IDD-su18/hw3-jasonxzhou/misc/image002.jpg

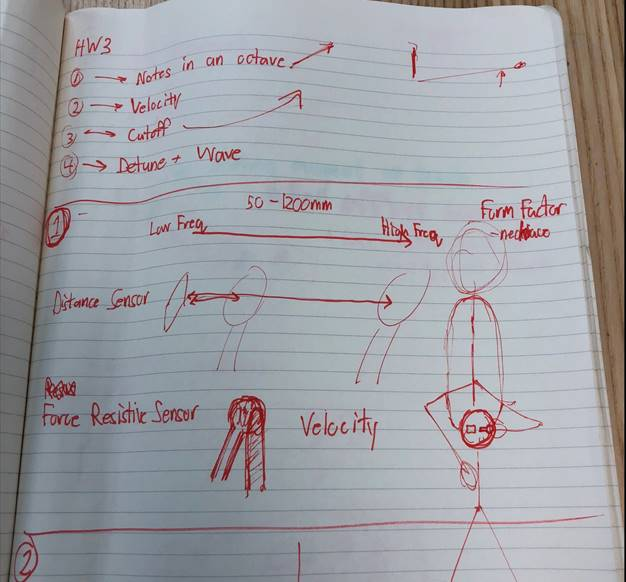
misc/image002.jpg
