IDD-su18/hw3-jasonxzhou/misc/image005.jpg

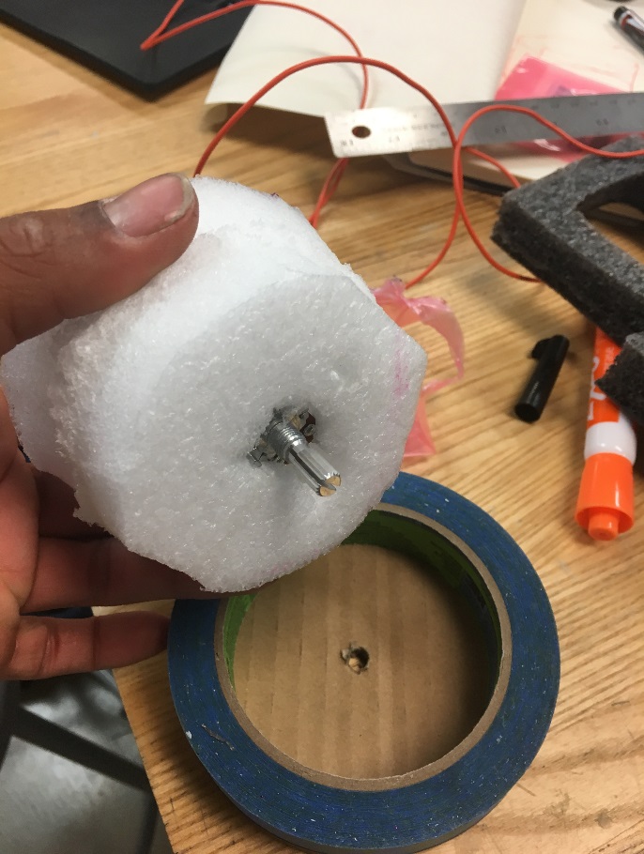
misc/image005.jpg
