IDD-su18/hw3-jasonxzhou/misc/image007.jpg

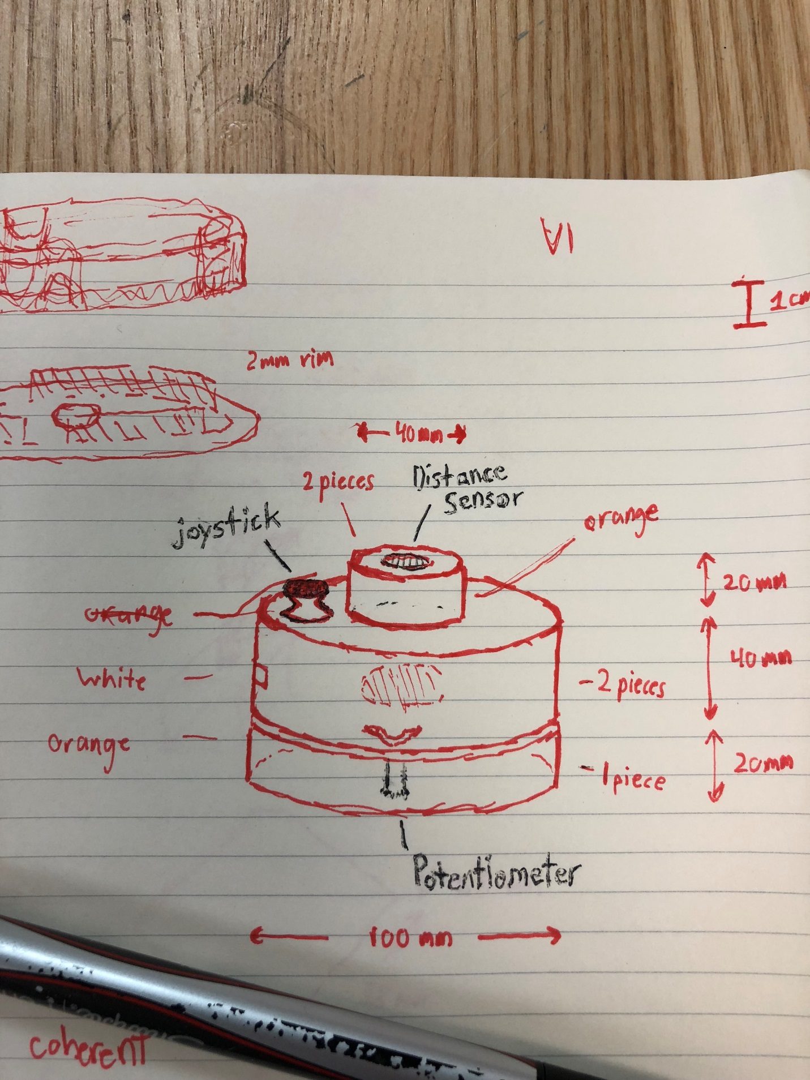
misc/image007.jpg
