IDD-su18/hw3-jasonxzhou/misc/image025.jpg

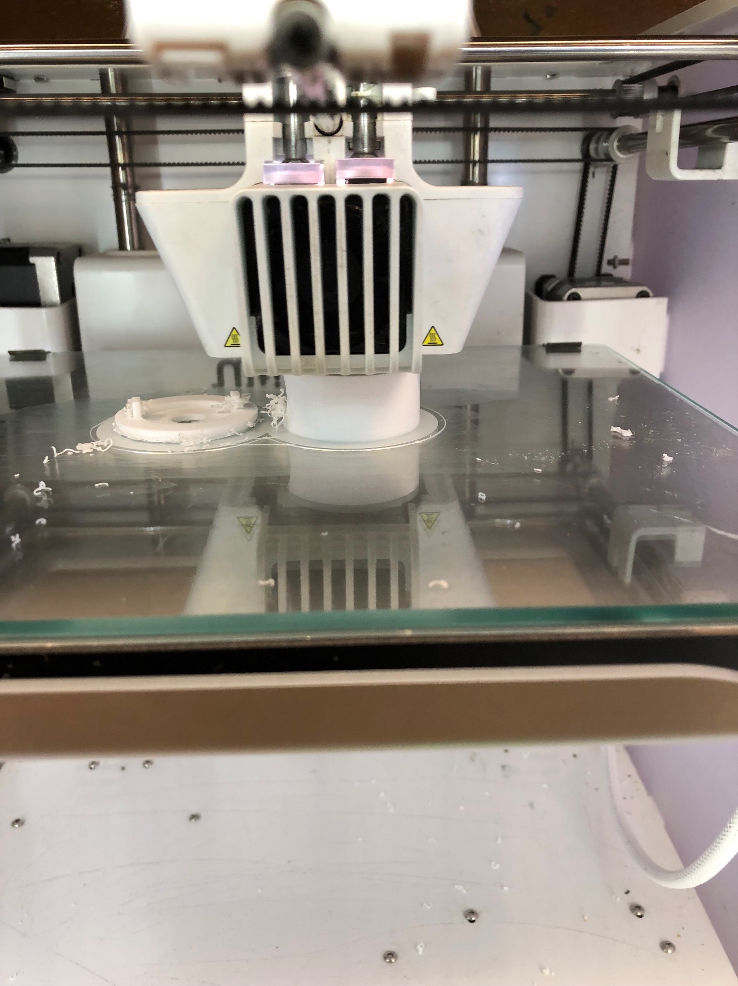
misc/image025.jpg
