IDD-su18/hw3-jasonxzhou/misc/image027.jpg

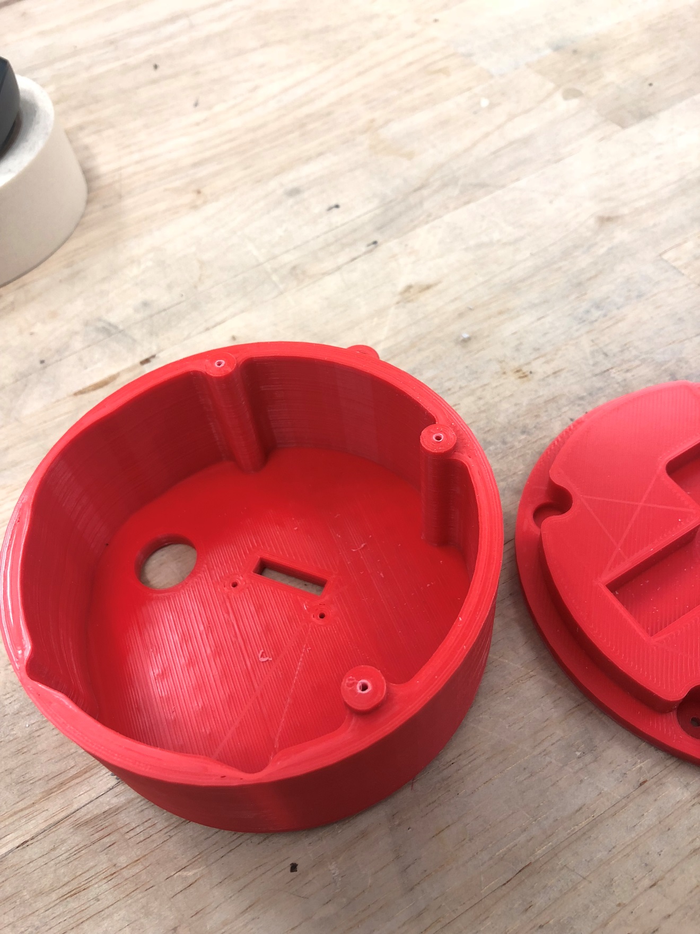
misc/image027.jpg
