IDD-su18/hw3-jasonxzhou/misc/image029.jpg

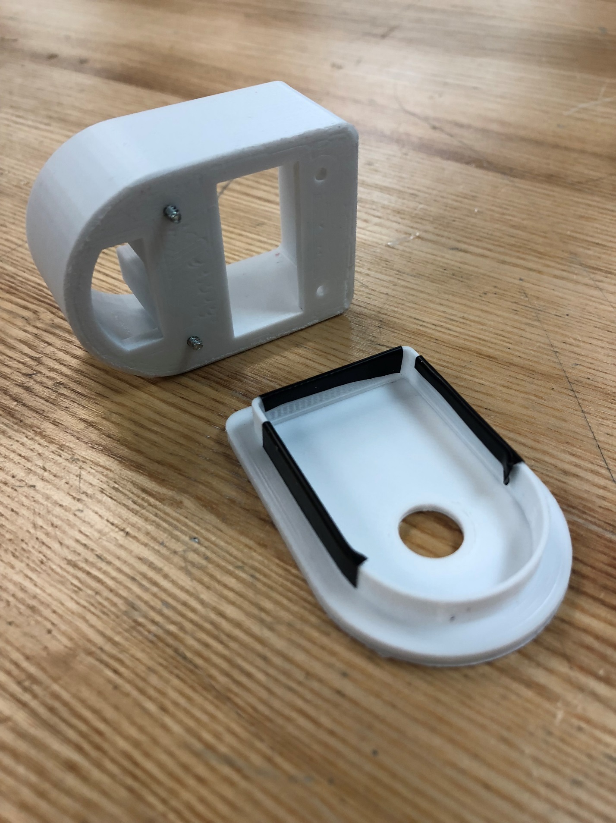
misc/image029.jpg
