IDD-su18/hw3-jasonxzhou/misc/image031.jpg

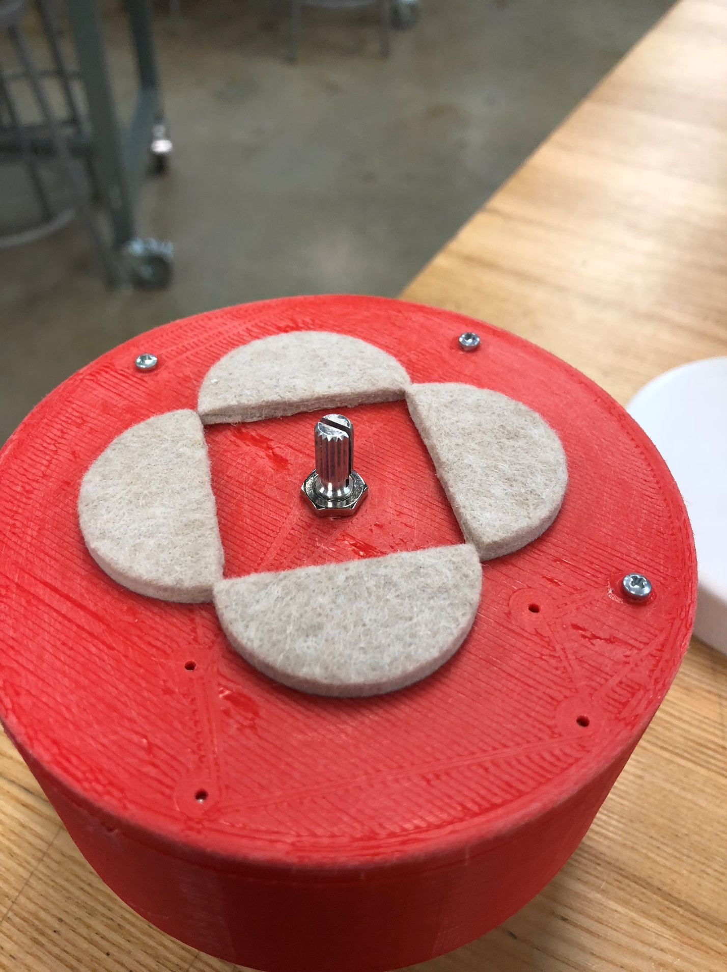
misc/image031.jpg
