IDD-su18/hw3-jasonxzhou/misc/image035.jpg

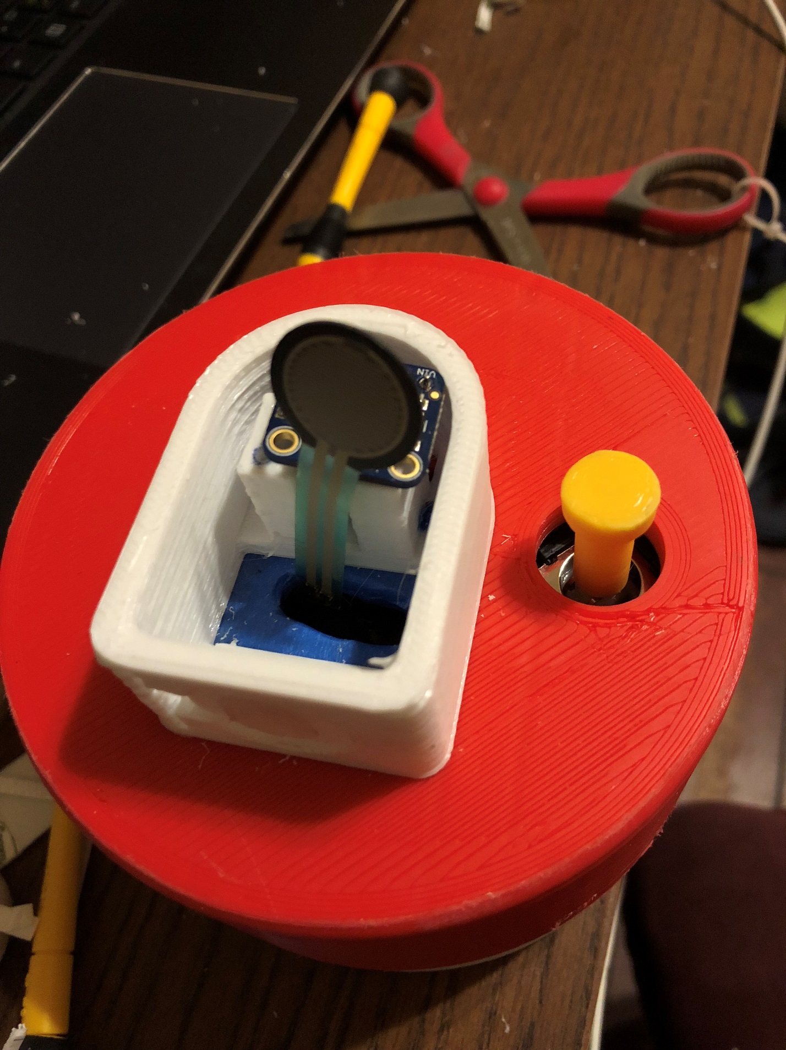
misc/image035.jpg
