IDD-su18/hw3-jasonxzhou/misc/image039.jpg

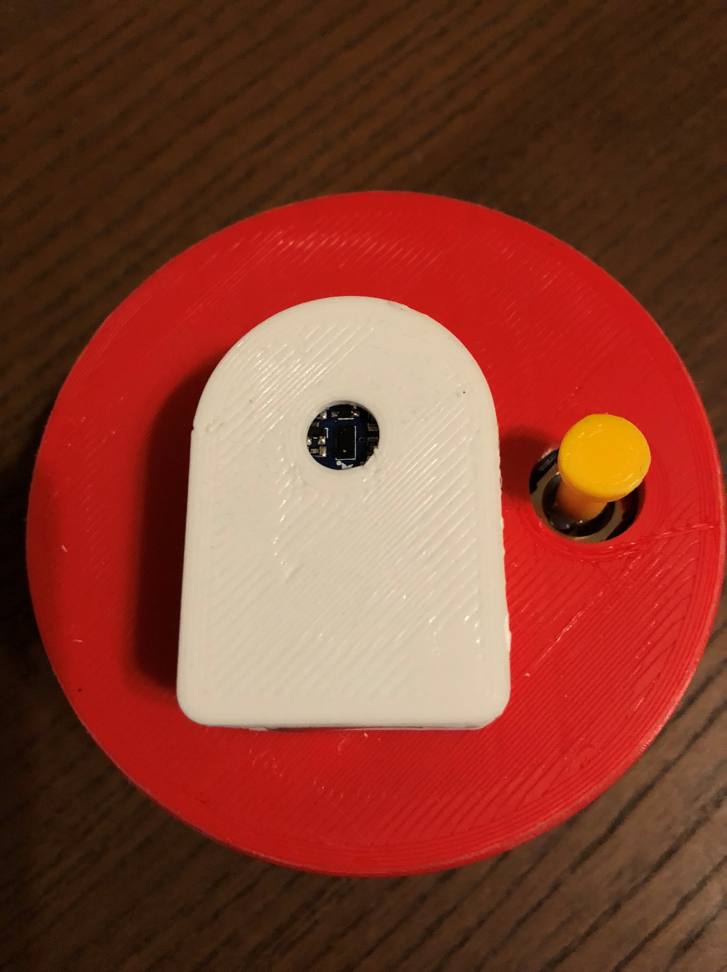
misc/image039.jpg
