IDD-su18/hw3-jasonxzhou/misc/image041.jpg

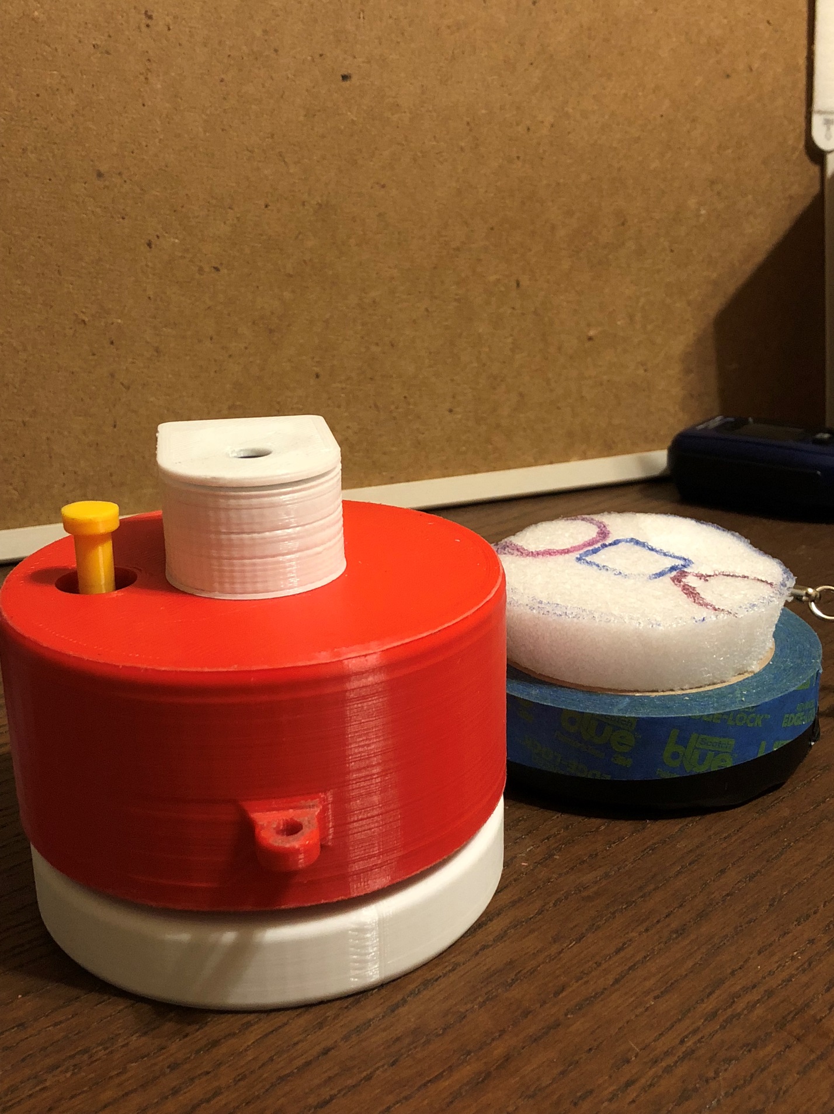
misc/image041.jpg
