IDD-su18/hw3-jasonxzhou/misc/image042.jpg

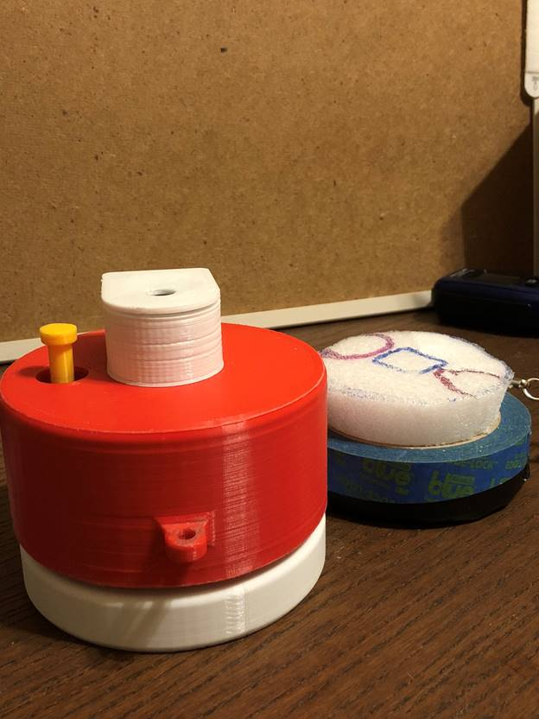
misc/image042.jpg
