IDD-su18/hw3-jasonxzhou/misc/image043.jpg

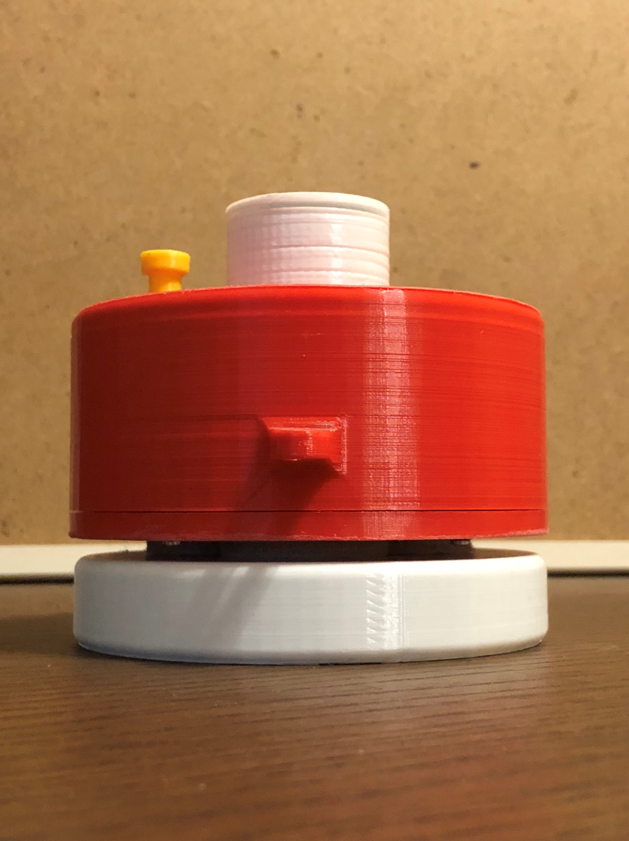
misc/image043.jpg
