IDD-su18/hw3-jasonxzhou/misc/image045.jpg

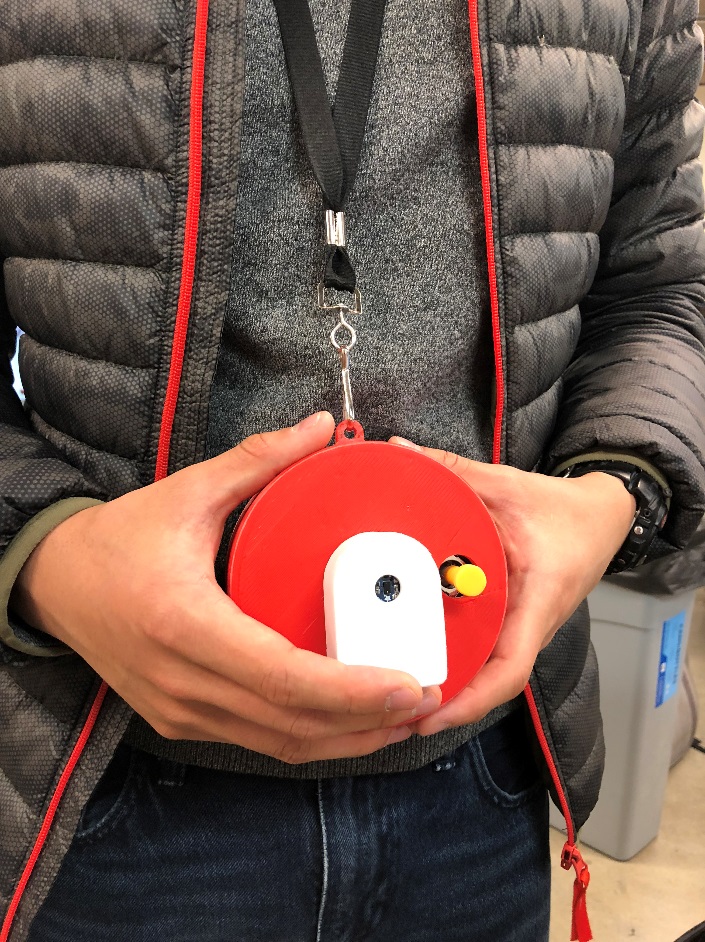
misc/image045.jpg
