IDD-su18/hw3-jasonxzhou/misc/image047.jpg

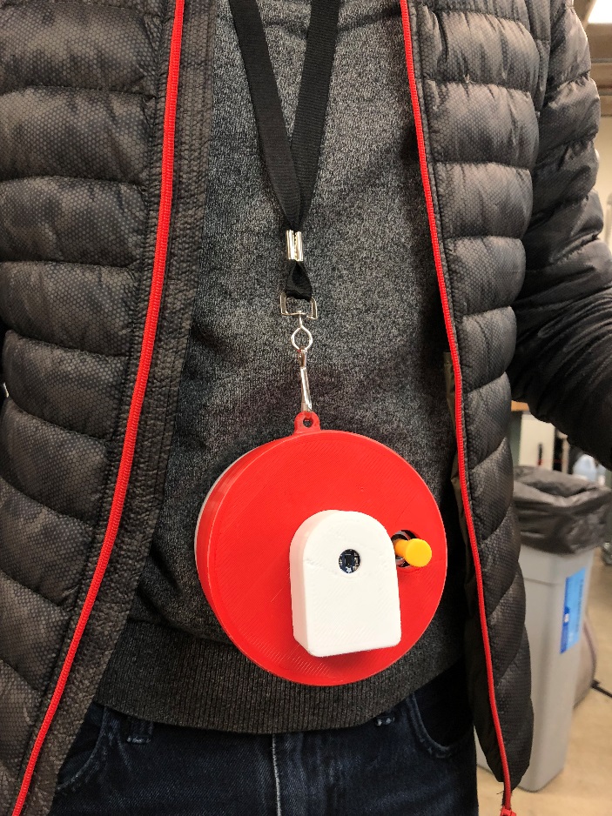
misc/image047.jpg
