IDD-su18/hw3-jasonxzhou/(commit log)

2018-06-28 figuring out midi chain
2018-06-28 tested sensors, figured out values/ranges
2018-06-29 communications code overhaul, now can send 4 MIDI messages at once polling rate of 10hz
